gabsfredes/PinBall/README.md

# PinBall Game

O Projeto **PinBall Game** foi desenvolvido a partir da proposta de projeto final da disciplina de Microcontroladores, da Fundação Universidade Federal do Pampa *(UNIPAMPA)*, cursada pelos alunos presentes como autores neste repositório.

## Autores

- Gabriel Dalmazo Dambros / [@gabrieldal](https://www.github.com/gabrieldal )
- Gabriel dos Santos Fredes / [@gabsfredes](https://www.github.com/gabsfredes)
- Vinicius Martins Faria / [@ViniciusMartinsFaria](https://www.github.com/ViniciusMartinsFaria)

## Documentação

[Relatório Final](https://github.com/gabsfredes/PinBall/blob/e4b66faa908884678ff1347a4d8bd66c04dddd33/relat%C3%B3rio%20pinball.pdf)

## Funcionalidades

- Display de pontuação
- Buzzer para efeitos sonoros
- Sensores para pontuar

## Contribuições

Contribuições são sempre bem-vindas!

A idéia após finalização do projeto, é deixá-lo como open-source para qualquer pessoa implementar novas funcionalidades ou ajustar as atuais. A parte física do projeto será mantida na universidade para uso em eventos da mesma, ou projetos futuros de outros alunos.
